peanat-byte/stepper_juicer_v1/3d_models/BSZ340N08NS3GATMA1.step

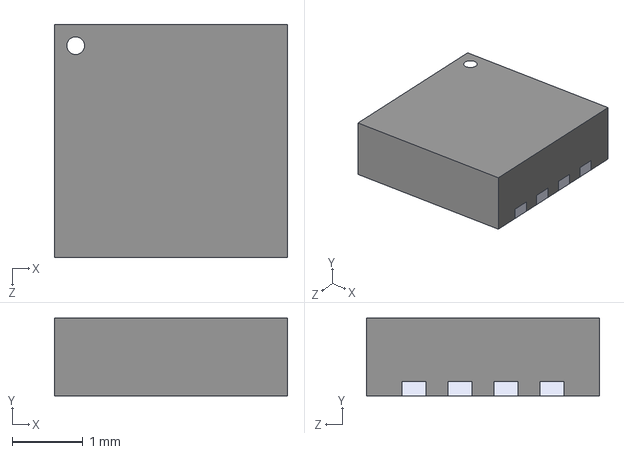
[picture p1: CAD file, 2025-09-15]
3d_models/BSZ340N08NS3GATMA1.step
3.30 x 1.10 x 3.30 mm
