peanat-byte/stepper_juicer_v1/stepper_juicer_v1.kicad_pcb

## KiCad design stepper_juicer_v1.kicad_pcb (2025-09-26)

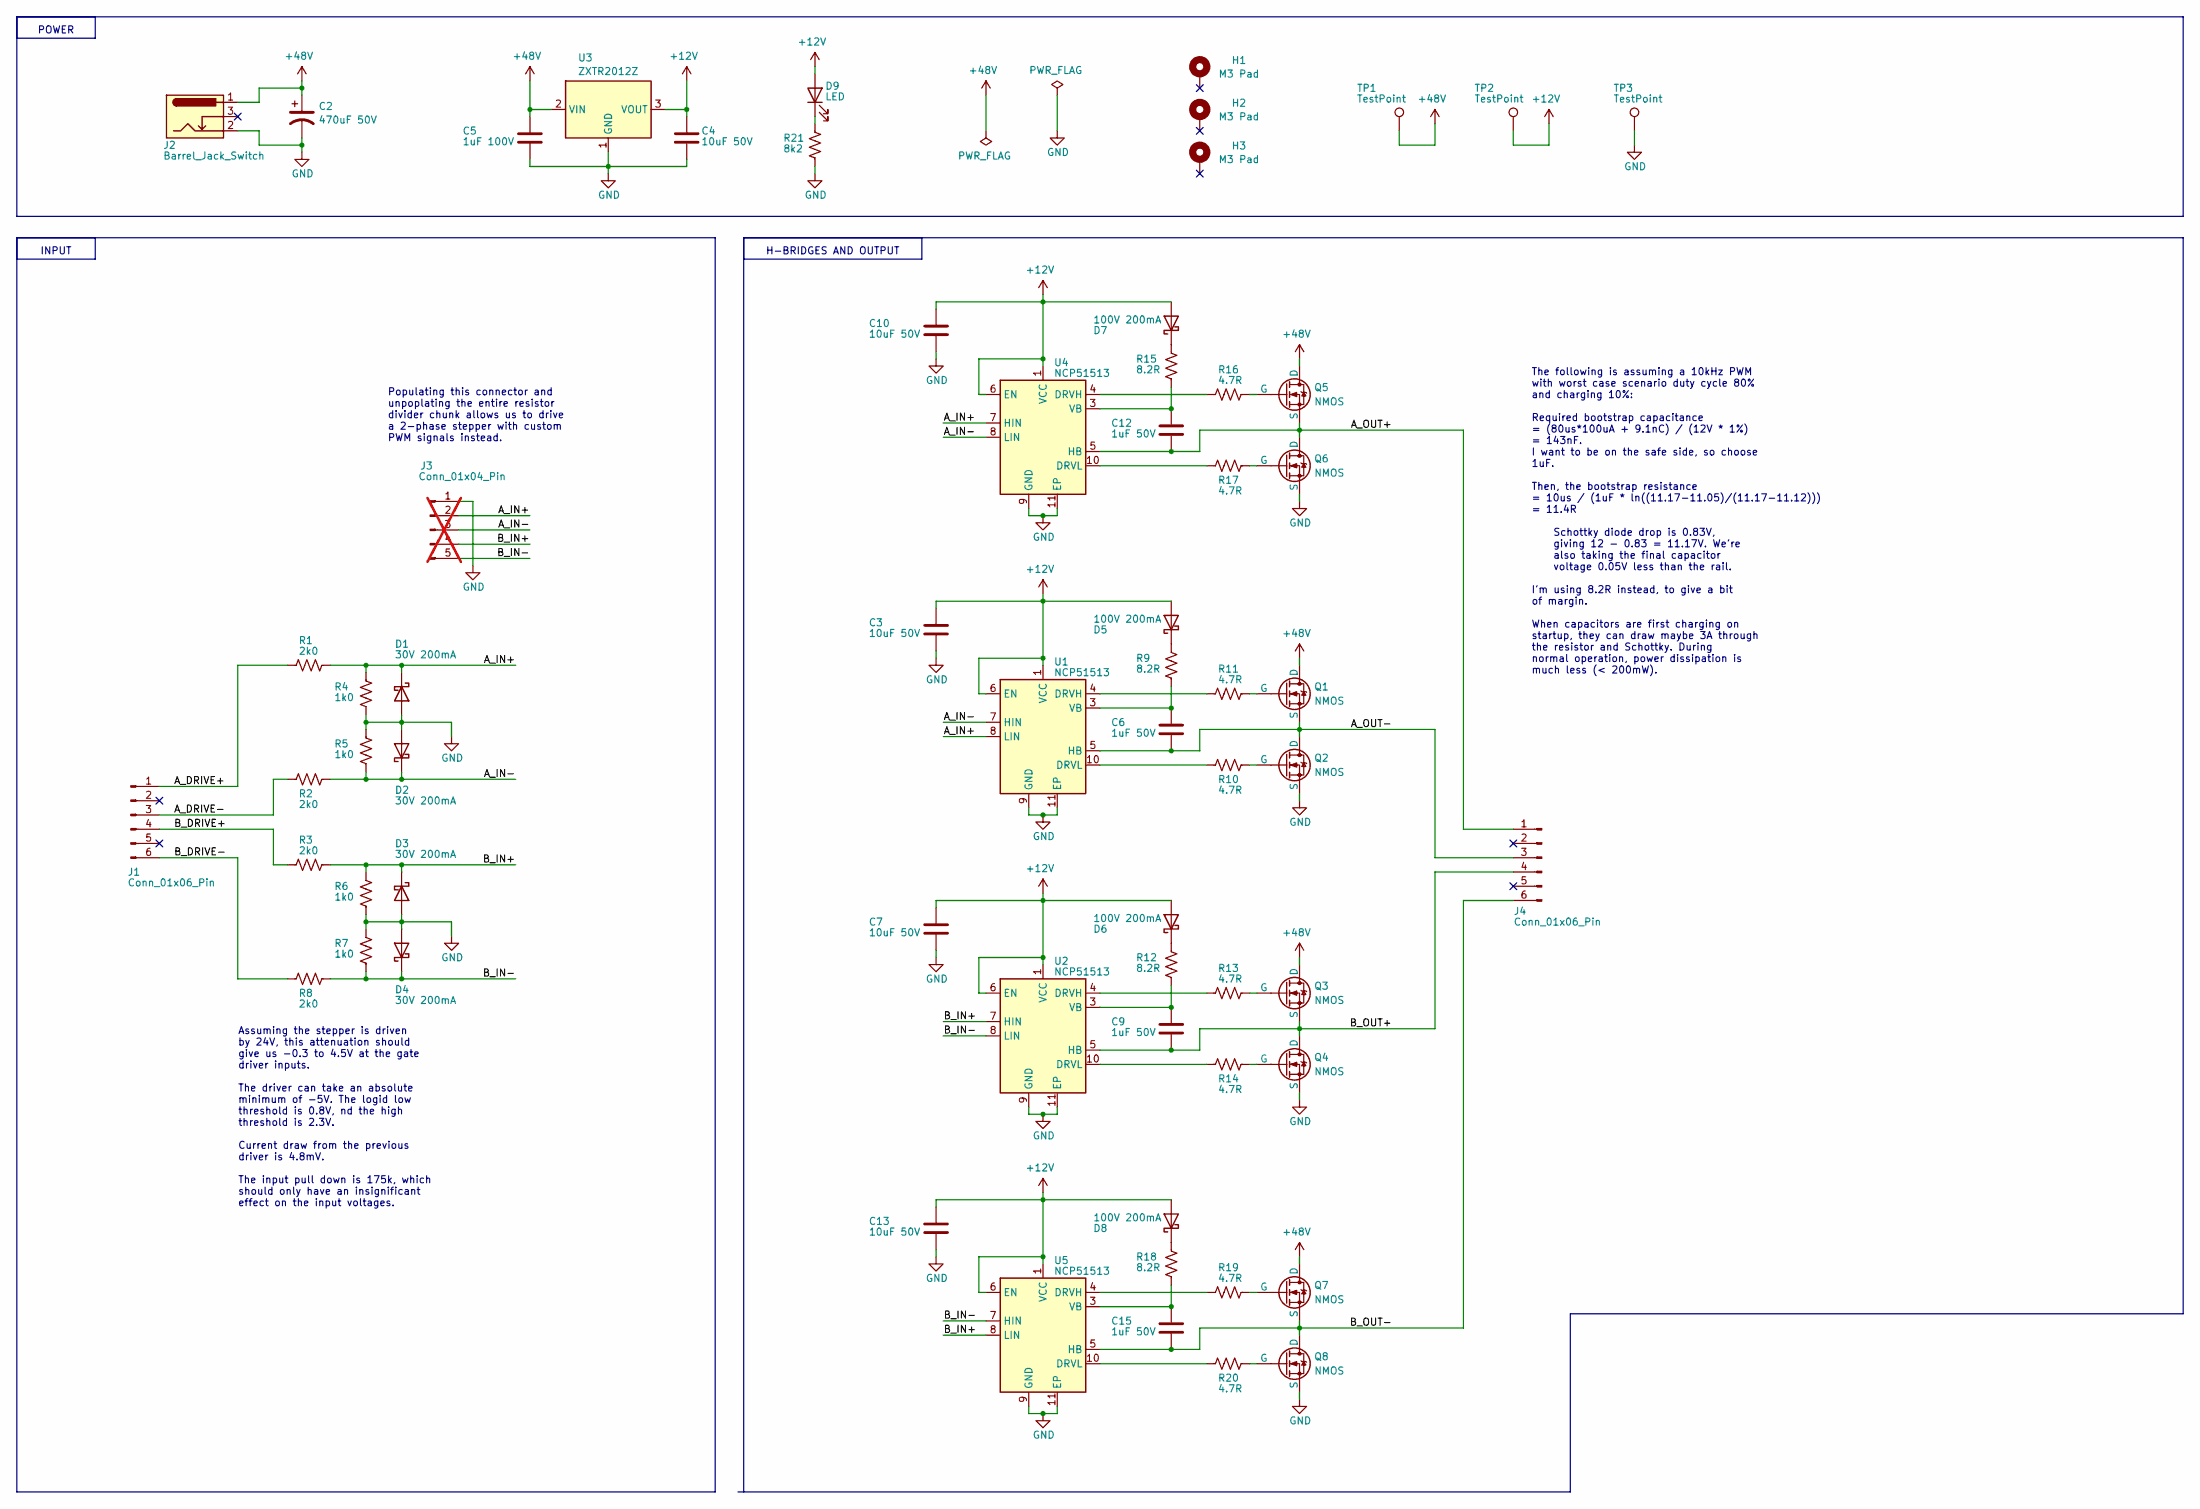
[picture p2: schematic stepper_juicer_v1.kicad_sch]

Parts:
C2: 470uF 50V; CP_Radial_D10.0mm_P5.00mm
C3, C4, C7, C10, C13: 10uF 50V; C_0805_2012Metric
C5: 1uF 100V; C_0805_2012Metric
C6, C9, C12, C15: 1uF 50V; C_0805_2012Metric
D1, D2, D3, D4: 30V 200mA; D_SOD-523
D5, D6, D7, D8: 100V 200mA; D_SOD-323F
D9: LED; D_0603_1608Metric
H1, H2, H3: M3 Pad; MountingHole_3.2mm_M3_Pad
J1, J4: Conn_01x06_Pin; JST_PH_B6B-PH-K_1x06_P2.00mm_Vertical
J2: Barrel_Jack_Switch; BarrelJack_GCT_DCJ200-10-A_Horizontal
J3: Conn_01x04_Pin; JST_XH_B5B-XH-A_1x05_P2.50mm_Vertical; not fitted
Q1, Q2, Q3, Q4, Q5, Q6, Q7, Q8: NMOS; PG-TSDSON-8_3.8x2.29_Pitch0.65mm
R1, R2, R3, R8: 2k0; R_0603_1608Metric
R4, R5, R6, R7: 1k0; R_0603_1608Metric
R9, R12, R15, R18: 8.2R; R_0603_1608Metric
R10, R11, R13, R14, R16, R17, R19, R20: 4.7R; R_0805_2012Metric
R21: 8k2; R_0603_1608Metric
TP1, TP2, TP3: TestPoint; TestPoint_Pad_D1.0mm
U1, U2, U4, U5: NCP51513; DFN-10-1EP_3x3mm_P0.5mm_EP1.7x2.5mm
U3: ZXTR2012Z; SOT-89-3

Connections:
+12V: C3.1, C4.1, C7.1, C10.1, C13.1, D5.2 (A), D6.2 (A), D7.2 (A), D8.2 (A), D9.2 (A), TP2.1, U1.1 (VCC), U1.6 (EN), U2.1 (VCC), U2.6 (EN), U3.3 (VOUT), U4.1 (VCC), U4.6 (EN), U5.1 (VCC), U5.6 (EN)
+48V: C2.1, C5.1, J2.1, Q1.1 (D), Q3.1 (D), Q5.1 (D), Q7.1 (D), TP1.1, U3.2 (VIN)
/A_DRIVE+: J1.1, R1.2
/A_DRIVE-: J1.3, R2.2
/A_IN+: D1.1 (K), J3.2, R1.1, R4.1, U1.8 (LIN), U4.7 (HIN)
/A_IN-: D2.1 (K), J3.3, R2.1, R5.2, U1.7 (HIN), U4.8 (LIN)
/A_OUT+: C12.2, J4.1, Q5.3 (S), Q6.1 (D), U4.5 (HB)
/A_OUT-: C6.2, J4.3, Q1.3 (S), Q2.1 (D), U1.5 (HB)
/B_DRIVE+: J1.4, R3.2
/B_DRIVE-: J1.6, R8.2
/B_IN+: D3.1 (K), J3.4, R3.1, R6.1, U2.7 (HIN), U5.8 (LIN)
/B_IN-: D4.1 (K), J3.5, R7.2, R8.1, U2.8 (LIN), U5.7 (HIN)
/B_OUT+: C9.2, J4.4, Q3.3 (S), Q4.1 (D), U2.5 (HB)
/B_OUT-: C15.2, J4.6, Q7.3 (S), Q8.1 (D), U5.5 (HB)
GND: C2.2, C3.2, C4.2, C5.2, C7.2, C10.2, C13.2, D1.2 (A), D2.2 (A), D3.2 (A), D4.2 (A), J2.2, J3.1, Q2.3 (S), Q4.3 (S), Q6.3 (S), Q8.3 (S), R4.2, R5.1, R6.2, R7.1, R21.2, TP3.1, U1.9 (GND), U1.11 (EP), U2.9 (GND), U2.11 (EP), U3.1 (GND), U4.9 (GND), U4.11 (EP), U5.9 (GND), U5.11 (EP)
unnamed: D5.1 (K), R9.2
unnamed: D6.1 (K), R12.2
unnamed: D7.1 (K), R15.2
unnamed: D8.1 (K), R18.2
unnamed: D9.1 (K), R21.1
unnamed: Q1.2 (G), R11.1
unnamed: Q2.2 (G), R10.1
unnamed: Q3.2 (G), R13.1
unnamed: Q4.2 (G), R14.1
unnamed: Q5.2 (G), R16.1
unnamed: Q6.2 (G), R17.1
unnamed: Q7.2 (G), R19.1
unnamed: Q8.2 (G), R20.1
unnamed: R11.2, U1.4 (DRVH)
unnamed: R10.2, U1.10 (DRVL)
unnamed: C6.1, R9.1, U1.3 (VB)
unnamed: R13.2, U2.4 (DRVH)
unnamed: R14.2, U2.10 (DRVL)
unnamed: C9.1, R12.1, U2.3 (VB)
unnamed: R16.2, U4.4 (DRVH)
unnamed: R17.2, U4.10 (DRVL)
unnamed: C12.1, R15.1, U4.3 (VB)
unnamed: R19.2, U5.4 (DRVH)
unnamed: R20.2, U5.10 (DRVL)
unnamed: C15.1, R18.1, U5.3 (VB)

Notes on the sheet:
H-BRIDGES AND OUTPUT
The following is assuming a 10kHz PWM with worst case scenario duty cycle 80% and charging 10%: Required bootstrap capacitance = (80us*100uA + 9.1nC) / (12V * 1%) = 143nF. I want to be on the safe side, so choose 1uF. Then, the bootstrap resistance = 10us / (1uF * ln((11.17-11.05)/(11.17-11.12))) =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
INPUT
Assuming the stepper is driven by 24V, this attenuation should give us -0.3 to 4.5V at the gate driver inputs. The driver can take an absolute minimum of -5V. The logid low threshold is 0.8V, nd the high threshold is 2.3V. Current draw from the previous driver is 4.8mV. The input pull down is 175k,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
POWER
Populating this connector and unpoplating the entire resistor divider chunk allows us to drive a 2-phase stepper with custom PWM signals instead.

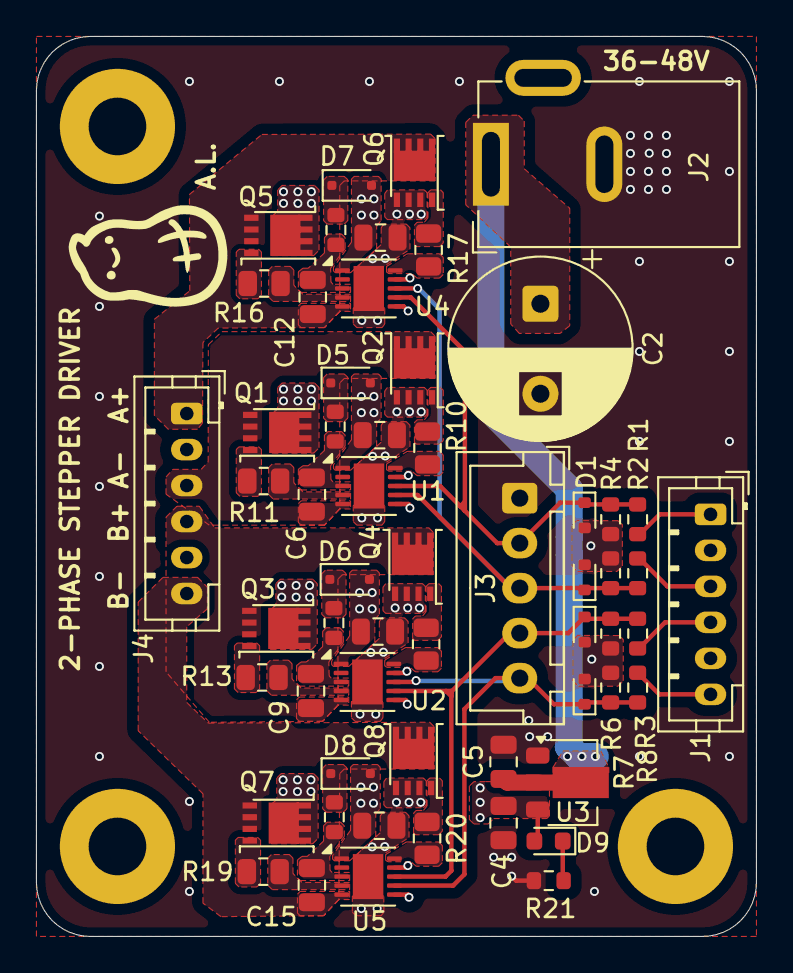
[picture p3: board stepper_juicer_v1.kicad_pcb from above]

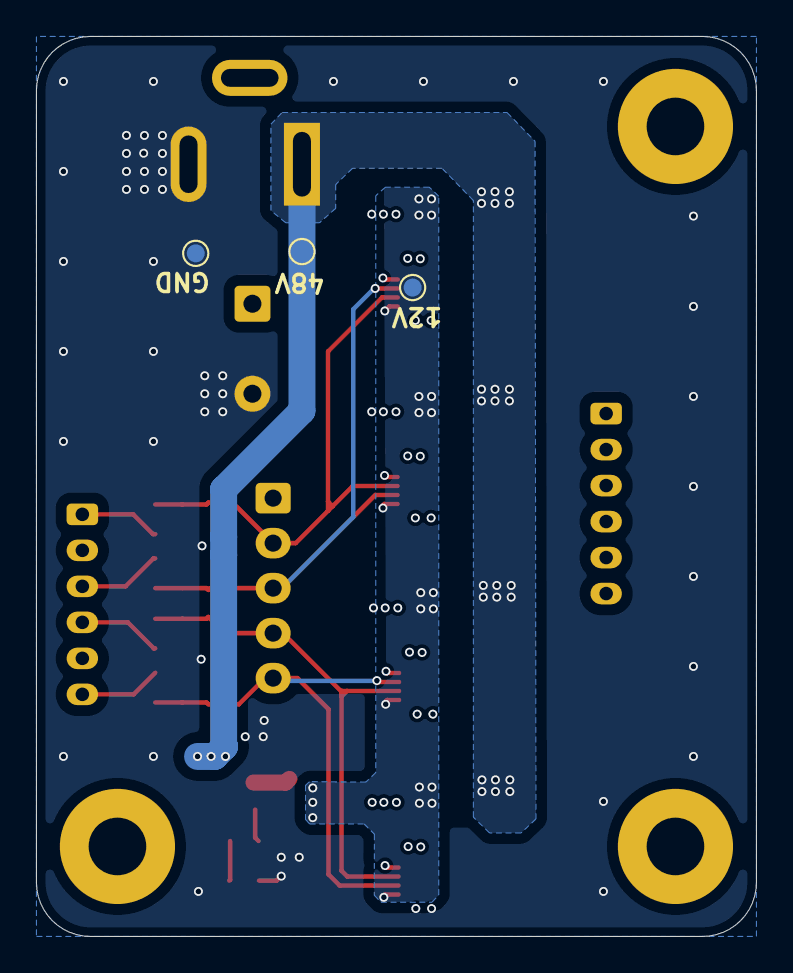
[picture p4: board stepper_juicer_v1.kicad_pcb from below]

Board: 4 copper layers, 40.0 x 50.0 mm, 64 parts (3 on the bottom side), 40 nets.
