peanat-byte/stepper_juicer_v1/(commit log)

2025-09-14 Start schematic
    [stepper_juicer_v1.kicad_pcb, stepper_juicer_v1.kicad_sch]
2025-09-15 Schematic done
    [BSZ340N08NS3GATMA1.step, stepper_juicer_v1.kicad_pcb, stepper_juicer_v1.kicad_sch]
2025-09-22 Finish design
    [stepper_juicer_v1-B_Cu.gbl, stepper_juicer_v1-B_Mask.gbs, stepper_juicer_v1-B_Paste.gbp, stepper_juicer_v1-B_Silkscreen.gbo, stepper_juicer_v1-Edge_Cuts.gm1, stepper_juicer_v1-F_Cu.gtl, stepper_juicer_v1-F_Mask.gts, stepper_juicer_v1-F_Paste.gtp]
2025-09-26 Add ground pin
    [stepper_juicer_v1-B_Cu.gbl, stepper_juicer_v1-B_Mask.gbs, stepper_juicer_v1-B_Paste.gbp, stepper_juicer_v1-B_Silkscreen.gbo, stepper_juicer_v1-Edge_Cuts.gm1, stepper_juicer_v1-F_Cu.gtl, stepper_juicer_v1-F_Mask.gts, stepper_juicer_v1-F_Paste.gtp]
2025-09-26 fixup! Add ground pin
    Cosmetic change
    [stepper_juicer_v1.kicad_pcb]
